ChrisFrancoHansen/NASA-Mini-Moon-Rover-Payload/Supporting Figures/Moon Impact Sites.jpg

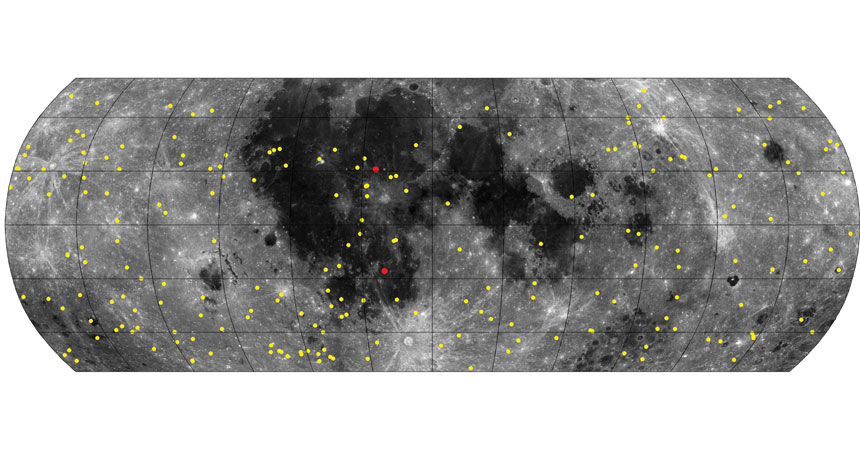
Supporting Figures/Moon Impact Sites.jpg
