ChrisFrancoHansen/NASA-Mini-Moon-Rover-Payload/Supporting Figures/Major Craters.PNG

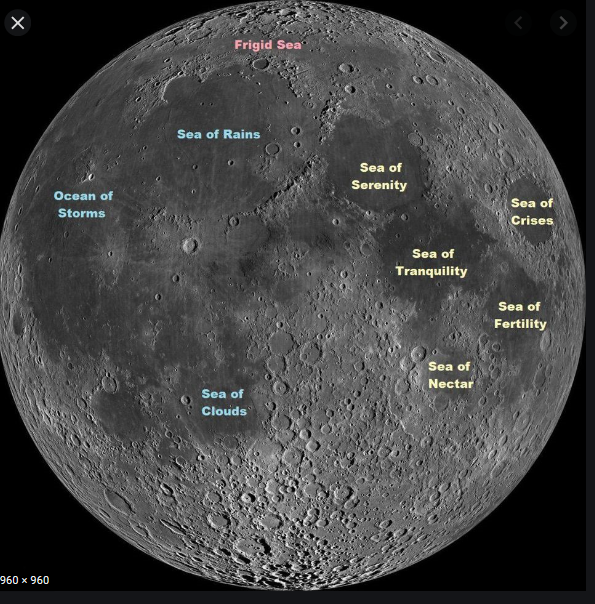
Supporting Figures/Major Craters.PNG
