ChrisFrancoHansen/NASA-Mini-Moon-Rover-Payload/Electrical Specs-Datasheets/DRV425 - System Parameter Calculator.xlsx

Sheet: Table of Content
Worksheets | Description
System Parameters | Lists the Magnetic Sensor Parameters and allows to change them according to the design requiremets.
 | Based on the inputs system parameters will be calculated.
 | Problems (e.g. over-load or over-range conditions) will be indicated in case of conflicting inputs.
Range Calculator | Helps to determine the maximum shunt resistance value. For 3 different reference voltage settings a matrix of resistance values is provided depending on the magnetic field and the applied power supply voltage.
B-Field Sweep | Compensation coil drive current and analog output voltage are shown over the magnetic field range.
 | Error and Over-range flag behavior is displayed to simulate the device behavior during the conditions under consideration.
Error Calculator | Different error components referred to the input magnetic field are calculated and listed based on the system parameters.
Gain vs Frequency | Open-loop and closed-loop gain and phase of the sensor are displayed over frequency.
Troubeshooting | Provides a detailed description of the problems flagged in the "DRV425 System Parameters" tab.
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
