ChrisFrancoHansen/NASA-Mini-Moon-Rover-Payload/Electrical Specs-Datasheets/Cancellation Solenoids.JPG

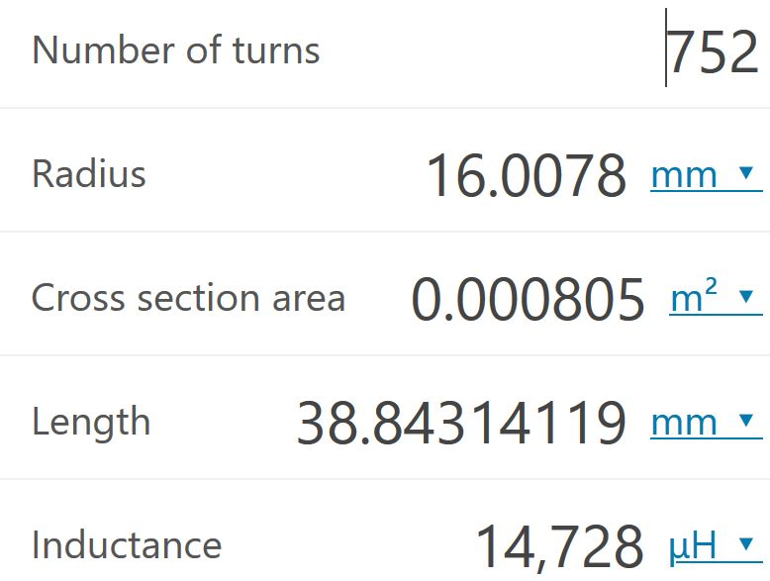
Electrical Specs-Datasheets/Cancellation Solenoids.JPG
