ChrisFrancoHansen/NASA-Mini-Moon-Rover-Payload/Electrical Specs-Datasheets/Exciting Solenoid Specs.JPG

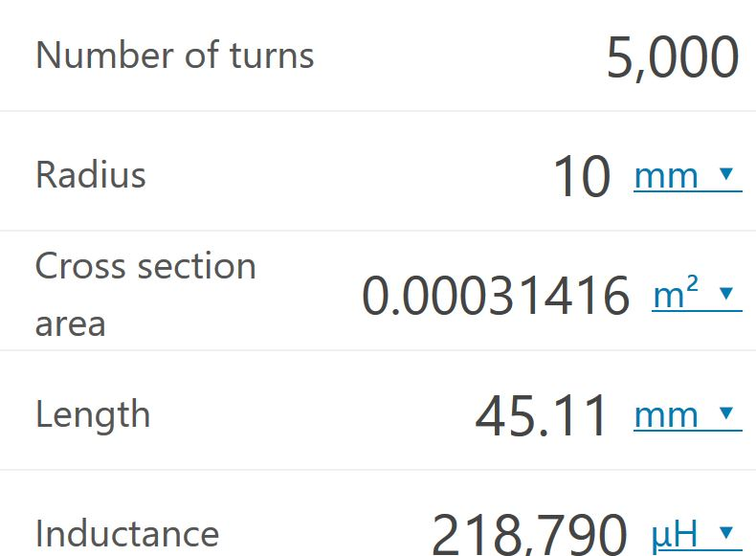
Electrical Specs-Datasheets/Exciting Solenoid Specs.JPG
