ChrisFrancoHansen/NASA-Mini-Moon-Rover-Payload/Electrical Specs-Datasheets/Fluxgate pins.JPG

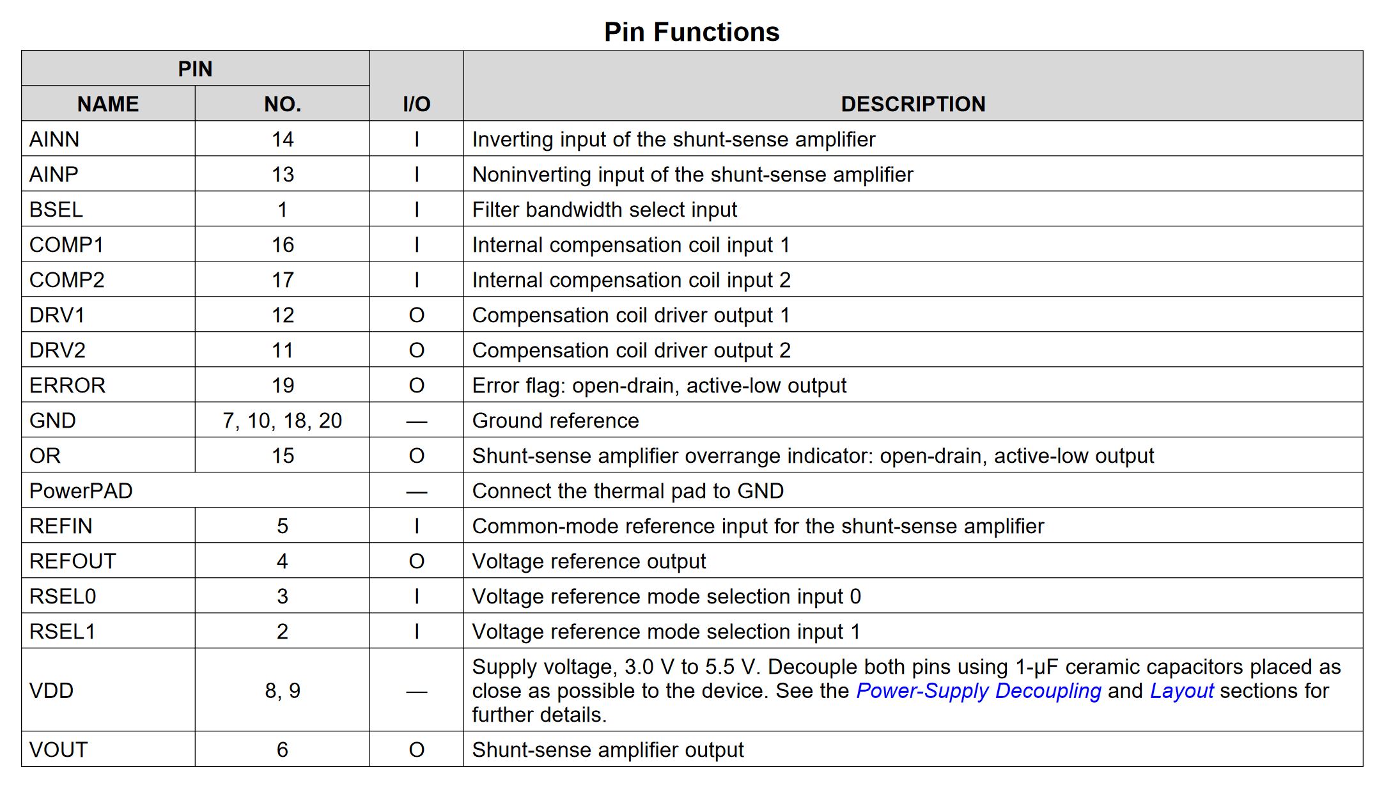
Electrical Specs-Datasheets/Fluxgate pins.JPG
