ChrisFrancoHansen/NASA-Mini-Moon-Rover-Payload/Supporting Figures/4-IdealMissionLocations.jpg

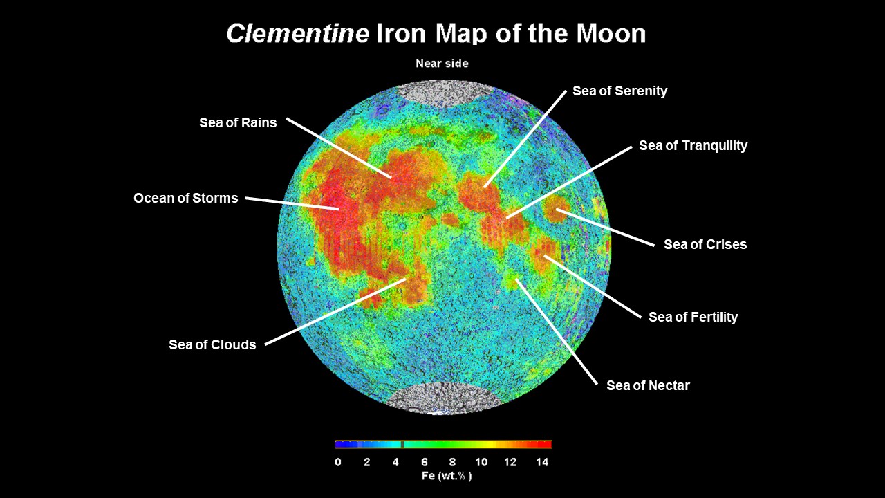
Supporting Figures/4-IdealMissionLocations.jpg
