ChrisFrancoHansen/NASA-Mini-Moon-Rover-Payload/Supporting Figures/Clementine.gif

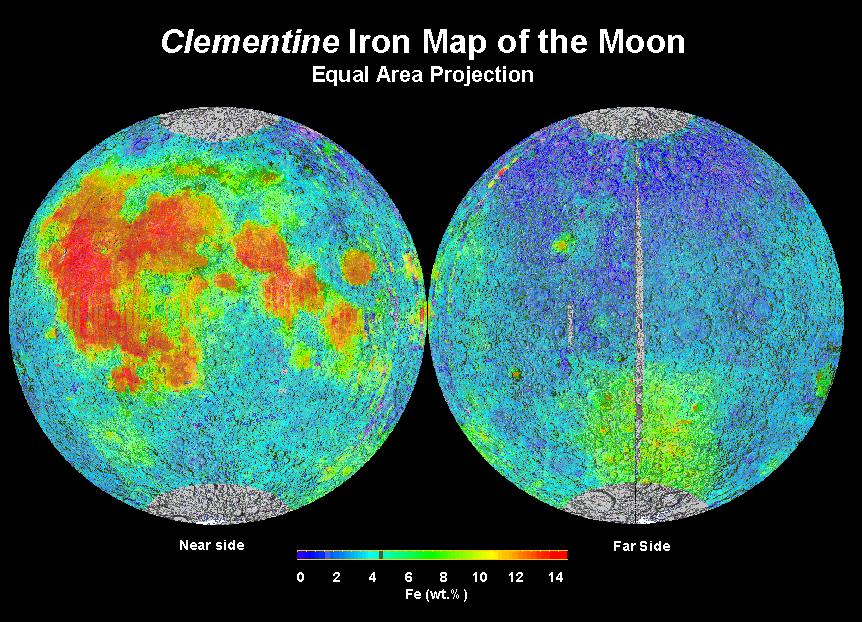
Supporting Figures/Clementine.gif
