ChrisFrancoHansen/NASA-Mini-Moon-Rover-Payload/Electrical Schematic.pdf

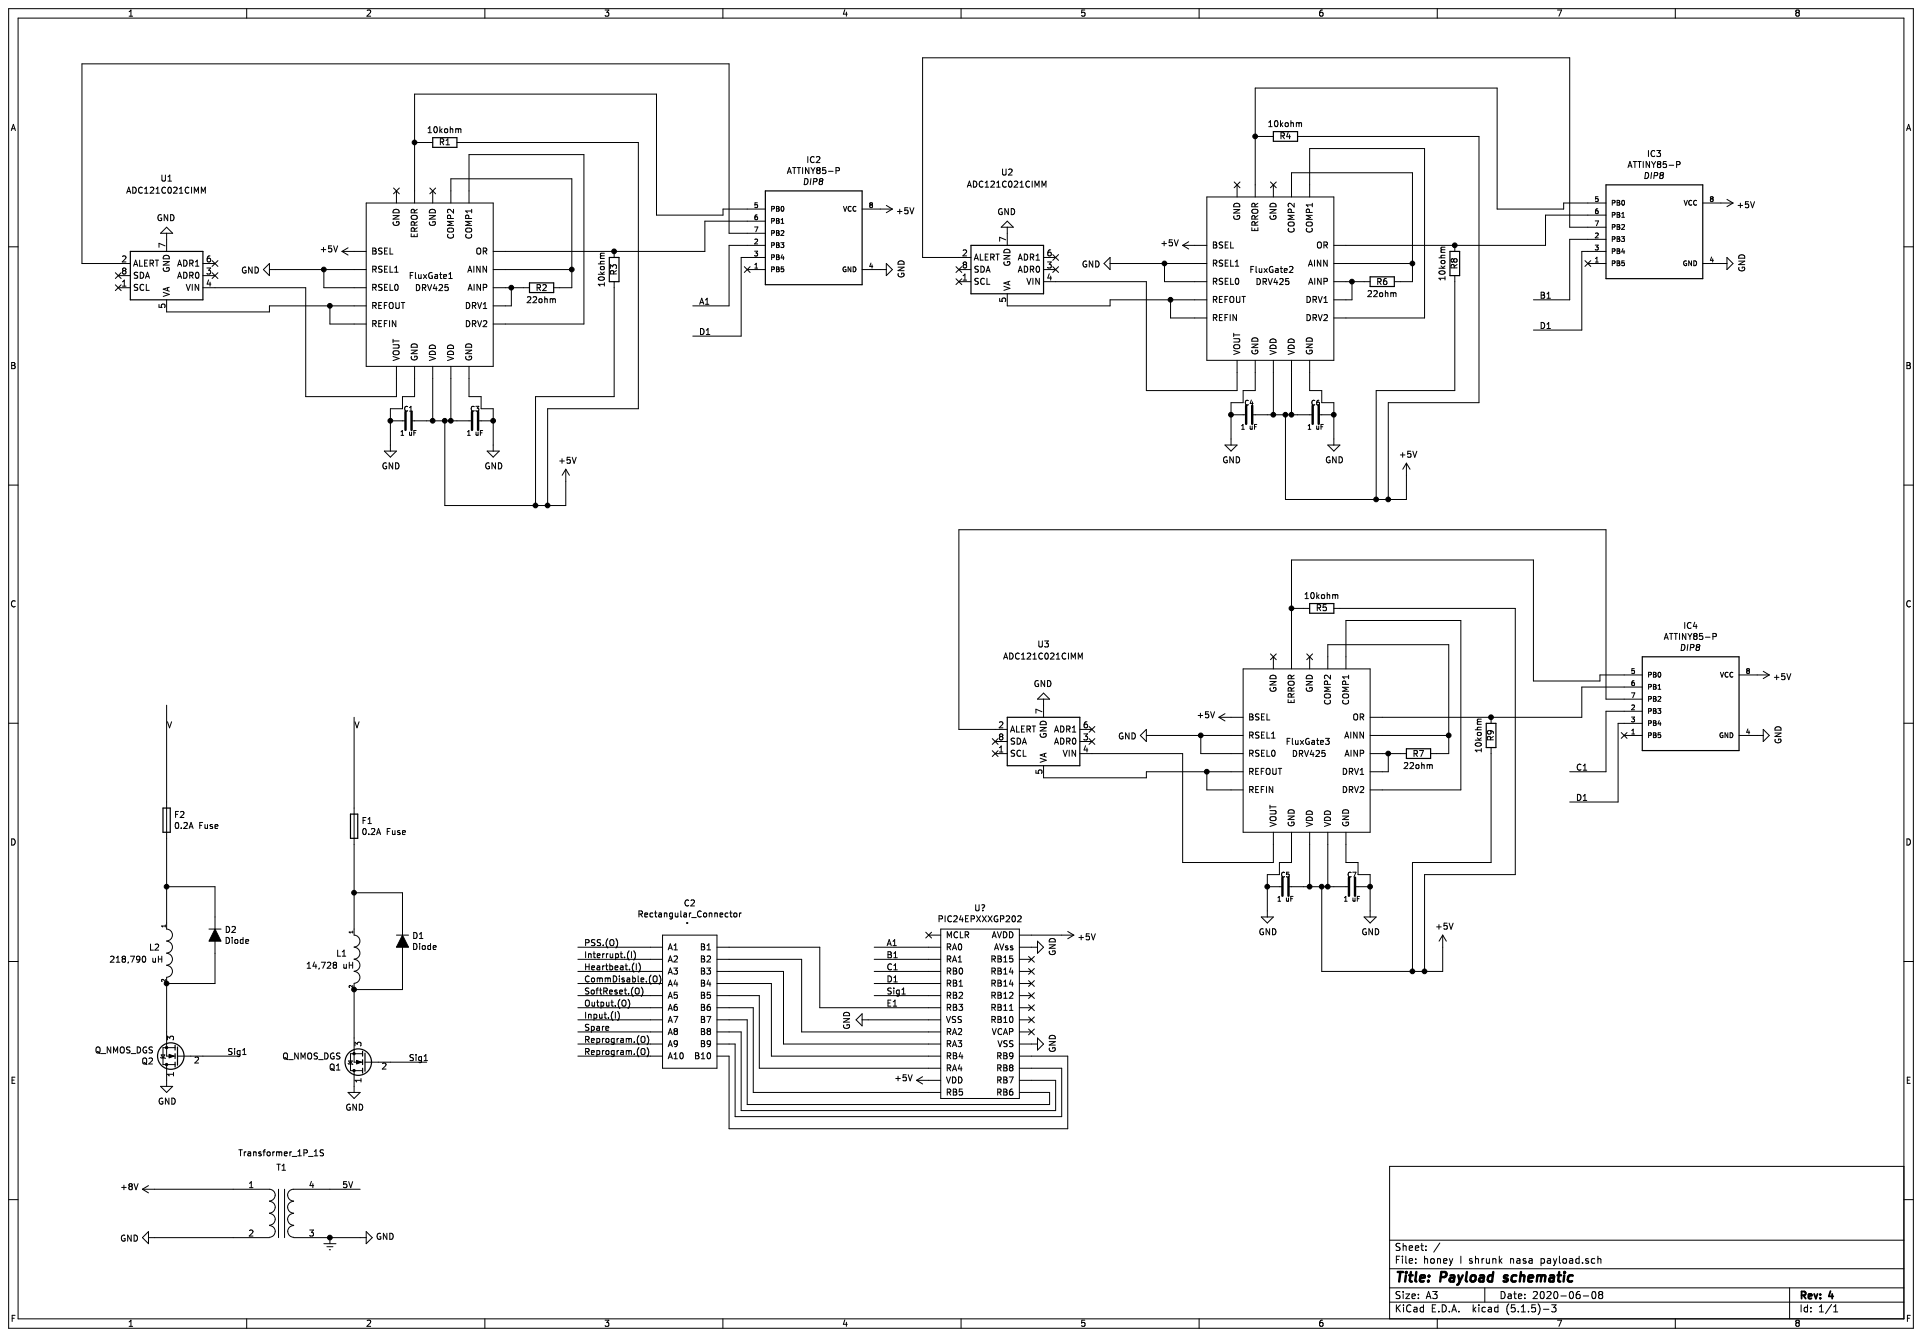
[picture p35: page 1]
